Daniel-Wareham/kerbal-controller/README.md

# kerbal-controller
An Arduino custom controller for Kerbal Space Program

Read the project log for my process in building the controller
Read the technical explanation for explanations on both the software and hardware
