Daniel-Wareham/kerbal-controller/Kerbal Body v3.7.stl

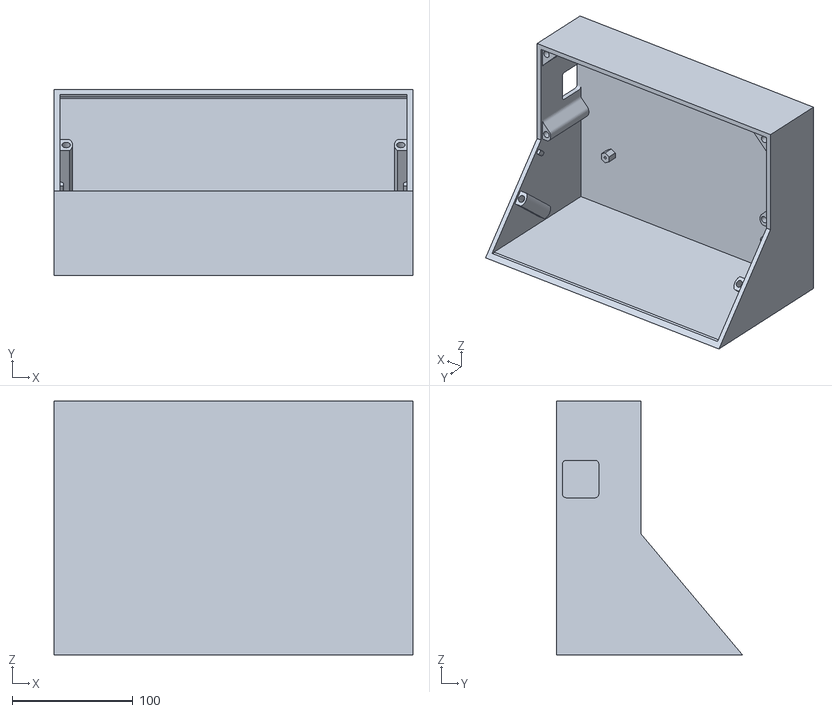
[picture p1: CAD file, 2020-08-31]
Kerbal Body v3.7.stl
297.0 x 153.9 x 210.0
