Daniel-Wareham/kerbal-controller/Kerbal Controller PCB/Kerbal Controller PCB.kicad_pcb

## KiCad design Kerbal Controller PCB/Kerbal Controller PCB.kicad_pcb (2020-08-27)

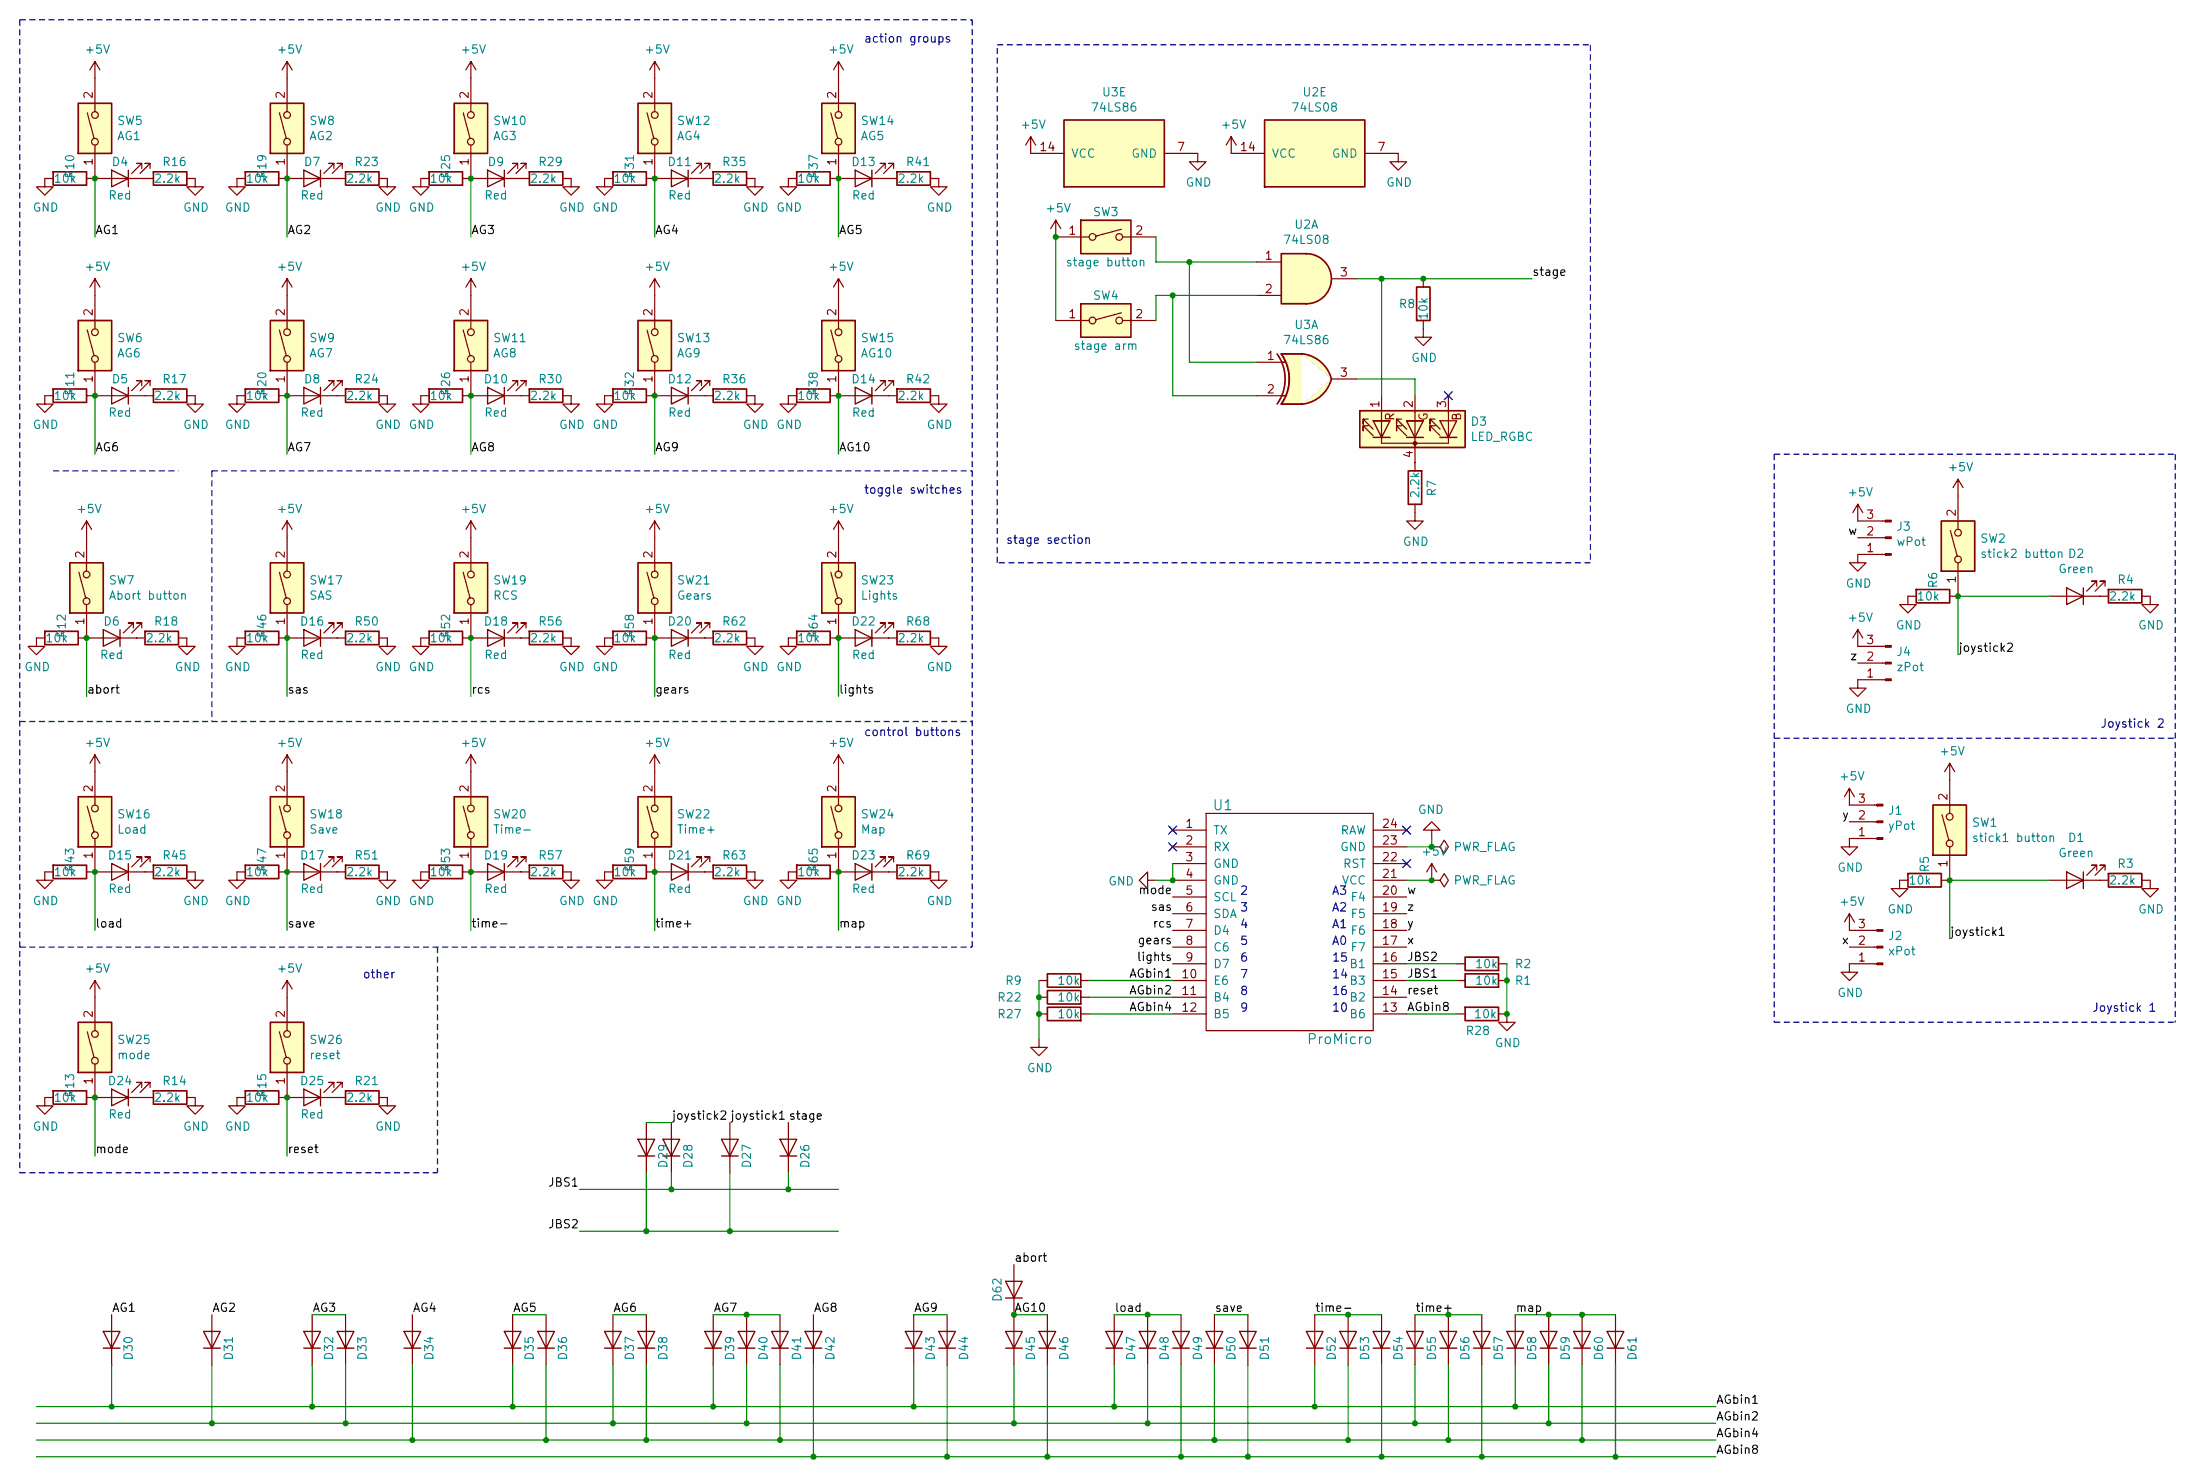
[picture p15: schematic Kerbal Controller PCB.sch]

Parts:
D1, D2: Green; LED_D5.0mm
D3: LED_RGBC; PinSocket_1x04_P2.54mm_Vertical
D4, D5, D6, D7, D8, D9, D10, D11, D12, D13, D14, D15, D16, D17, D18, D19, D20, D21, D22, D23, D24, D25: Red; LED_D5.0mm
D26, D27, D28, D29, D30, D31, D32, D33, D34, D35, D36, D37, D38, D39, D40, D41, D42, D43, D44, D45, D46, D47, D48, D49, D50, D51, D52, D53, D54, D55, D56, D57, D58, D59, D60, D61, D62: D; D_A-405_P7.62mm_Horizontal
J1: yPot; PinHeader_1x03_P2.54mm_Vertical
J2: xPot; PinHeader_1x03_P2.54mm_Vertical
J3: wPot; PinHeader_1x03_P2.54mm_Vertical
J4: zPot; PinHeader_1x03_P2.54mm_Vertical
R1, R2, R5, R6, R8, R9, R10, R11, R12, R13, R15, R19, R20, R22, R25, R26, R27, R28, R31, R32, R37, R38, R43, R46, R47, R52, R53, R58, R59, R64, R65: 10k; R_Axial_DIN0207_L6.3mm_D2.5mm_P7.62mm_Horizontal
R3, R4, R7, R14, R16, R17, R18, R21, R23, R24, R29, R30, R35, R36, R41, R42, R45, R50, R51, R56, R57, R62, R63, R68, R69: 2.2k; R_Axial_DIN0207_L6.3mm_D2.5mm_P7.62mm_Horizontal
SW1: stick1 button; PinHeader_1x02_P2.54mm_Vertical
SW2: stick2 button; PinHeader_1x02_P2.54mm_Vertical
SW3: stage button; PinHeader_1x02_P2.54mm_Vertical
SW4: stage arm; PinHeader_1x02_P2.54mm_Vertical
SW5: AG1; PinHeader_1x02_P2.54mm_Vertical
SW6: AG6; PinHeader_1x02_P2.54mm_Vertical
SW7: Abort button; PinHeader_1x02_P2.54mm_Vertical
SW8: AG2; PinHeader_1x02_P2.54mm_Vertical
SW9: AG7; PinHeader_1x02_P2.54mm_Vertical
SW10: AG3; PinHeader_1x02_P2.54mm_Vertical
SW11: AG8; PinHeader_1x02_P2.54mm_Vertical
SW12: AG4; PinHeader_1x02_P2.54mm_Vertical
SW13: AG9; PinHeader_1x02_P2.54mm_Vertical
SW14: AG5; PinHeader_1x02_P2.54mm_Vertical
SW15: AG10; PinHeader_1x02_P2.54mm_Vertical
SW16: Load; PinHeader_1x02_P2.54mm_Vertical
SW17: SAS; PinHeader_1x02_P2.54mm_Vertical
SW18: Save; PinHeader_1x02_P2.54mm_Vertical
SW19: RCS; PinHeader_1x02_P2.54mm_Vertical
SW20: Time-; PinHeader_1x02_P2.54mm_Vertical
SW21: Gears; PinHeader_1x02_P2.54mm_Vertical
SW22: Time+; PinHeader_1x02_P2.54mm_Vertical
SW23: Lights; PinHeader_1x02_P2.54mm_Vertical
SW24: Map; PinHeader_1x02_P2.54mm_Vertical
SW25: mode; PinHeader_1x02_P2.54mm_Vertical
SW26: reset; PinHeader_1x02_P2.54mm_Vertical
U1: ProMicro
U2: 74LS08; DIP-14_W7.62mm_LongPads
U3: 74LS86; DIP-14_W7.62mm_LongPads

Connections:
+5V: J1.3, J2.3, J3.3, J4.3, SW1.2, SW2.2, SW3.1, SW4.1, SW5.2, SW6.2, SW7.2, SW8.2, SW9.2, SW10.2, SW11.2, SW12.2, SW13.2, SW14.2, SW15.2, SW16.2, SW17.2, SW18.2, SW19.2, SW20.2, SW21.2, SW22.2, SW23.2, SW24.2, SW25.2, SW26.2, U1.21 (VCC), U2.14 (VCC), U3.14 (VCC)
/AG1: D4.2 (A), D30.2 (A), R10.1, SW5.1
/AG2: D7.2 (A), D31.2 (A), R19.1, SW8.1
/AG3: D9.2 (A), D32.2 (A), D33.2 (A), R25.1, SW10.1
/AG4: D11.2 (A), D34.2 (A), R31.1, SW12.1
/AG5: D13.2 (A), D35.2 (A), D36.2 (A), R37.1, SW14.1
/AG6: D5.2 (A), D37.2 (A), D38.2 (A), R11.1, SW6.1
/AG7: D8.2 (A), D39.2 (A), D40.2 (A), D41.2 (A), R20.1, SW9.1
/AG8: D10.2 (A), D42.2 (A), R26.1, SW11.1
/AG9: D12.2 (A), D43.2 (A), D44.2 (A), R32.1, SW13.1
/AG10: D14.2 (A), D45.2 (A), D46.2 (A), D62.1 (K), R38.1, SW15.1
/AGbin1: D30.1 (K), D32.1 (K), D35.1 (K), D39.1 (K), D43.1 (K), D47.1 (K), D52.1 (K), D58.1 (K), R9.2, U1.10 (E6)
/AGbin2: D31.1 (K), D33.1 (K), D37.1 (K), D40.1 (K), D45.1 (K), D48.1 (K), D55.1 (K), D59.1 (K), R22.2, U1.11 (B4)
/AGbin4: D34.1 (K), D36.1 (K), D38.1 (K), D41.1 (K), D50.1 (K), D53.1 (K), D56.1 (K), D60.1 (K), R27.2, U1.12 (B5)
/AGbin8: D42.1 (K), D44.1 (K), D46.1 (K), D49.1 (K), D51.1 (K), D54.1 (K), D57.1 (K), D61.1 (K), R28.2, U1.13 (B6)
/JBS1: D26.1 (K), D28.1 (K), R1.1, U1.15 (B3)
/JBS2: D27.1 (K), D29.1 (K), R2.1, U1.16 (B1)
/abort: D6.2 (A), D62.2 (A), R12.1, SW7.1
/gears: D20.2 (A), R58.1, SW21.1, U1.8 (C6)
/joystick1: D1.2 (A), D27.2 (A), R5.1, SW1.1
/joystick2: D2.2 (A), D28.2 (A), D29.2 (A), R6.1, SW2.1
/lights: D22.2 (A), R64.1, SW23.1, U1.9 (D7)
/load: D15.2 (A), D47.2 (A), D48.2 (A), D49.2 (A), R43.1, SW16.1
/map: D23.2 (A), D58.2 (A), D59.2 (A), D60.2 (A), D61.2 (A), R65.1, SW24.1
/mode: D24.2 (A), R13.1, SW25.1, U1.5 (SCL)
/rcs: D18.2 (A), R52.1, SW19.1, U1.7 (D4)
/reset: D25.2 (A), R15.1, SW26.1, U1.14 (B2)
/sas: D16.2 (A), R46.1, SW17.1, U1.6 (SDA)
/save: D17.2 (A), D50.2 (A), D51.2 (A), R47.1, SW18.1
/stage: D3.1 (RA), D26.2 (A), R8.1, U2.3
/time+: D21.2 (A), D55.2 (A), D56.2 (A), D57.2 (A), R59.1, SW22.1
/time-: D19.2 (A), D52.2 (A), D53.2 (A), D54.2 (A), R53.1, SW20.1
/w: J3.2, U1.20 (F4)
/x: J2.2, U1.17 (F7)
/y: J1.2, U1.18 (F6)
/z: J4.2, U1.19 (F5)
GND: J1.1, J2.1, J3.1, J4.1, R1.2, R2.2, R3.1, R4.1, R5.2, R6.2, R7.1, R8.2, R9.1, R10.2, R11.2, R12.2, R13.2, R14.1, R15.2, R16.1, R17.1, R18.1, R19.2, R20.2, R21.1, R22.1, R23.1, R24.1, R25.2, R26.2, R27.1, R28.1, R29.1, R30.1, R31.2, R32.2, R35.1, R36.1, R37.2, R38.2, R41.1, R42.1, R43.2, R45.1, R46.2, R47.2, R50.1, R51.1, R52.2, R53.2, R56.1, R57.1, R58.2, R59.2, R62.1, R63.1, R64.2, R65.2, R68.1, R69.1, U1.3 (GND), U1.4 (GND), U1.23 (GND), U2.7 (GND), U3.7 (GND)
unnamed: D1.1 (K), R3.2
unnamed: D2.1 (K), R4.2
unnamed: D3.2 (GA), U3.3
unnamed: D3.4 (K), R7.2
unnamed: D4.1 (K), R16.2
unnamed: D5.1 (K), R17.2
unnamed: D6.1 (K), R18.2
unnamed: D7.1 (K), R23.2
unnamed: D8.1 (K), R24.2
unnamed: D9.1 (K), R29.2
unnamed: D10.1 (K), R30.2
unnamed: D11.1 (K), R35.2
unnamed: D12.1 (K), R36.2
unnamed: D13.1 (K), R41.2
unnamed: D14.1 (K), R42.2
unnamed: D15.1 (K), R45.2
unnamed: D16.1 (K), R50.2
unnamed: D17.1 (K), R51.2
unnamed: D18.1 (K), R56.2
unnamed: D19.1 (K), R57.2
unnamed: D20.1 (K), R62.2
unnamed: D21.1 (K), R63.2
unnamed: D22.1 (K), R68.2
unnamed: D23.1 (K), R69.2
unnamed: D24.1 (K), R14.2
unnamed: D25.1 (K), R21.2
unnamed: SW3.2, U2.1, U3.1
unnamed: SW4.2, U2.2, U3.2

Notes on the sheet:
Joystick 2
Joystick 1
stage section
action groups
toggle switches
control buttons
other

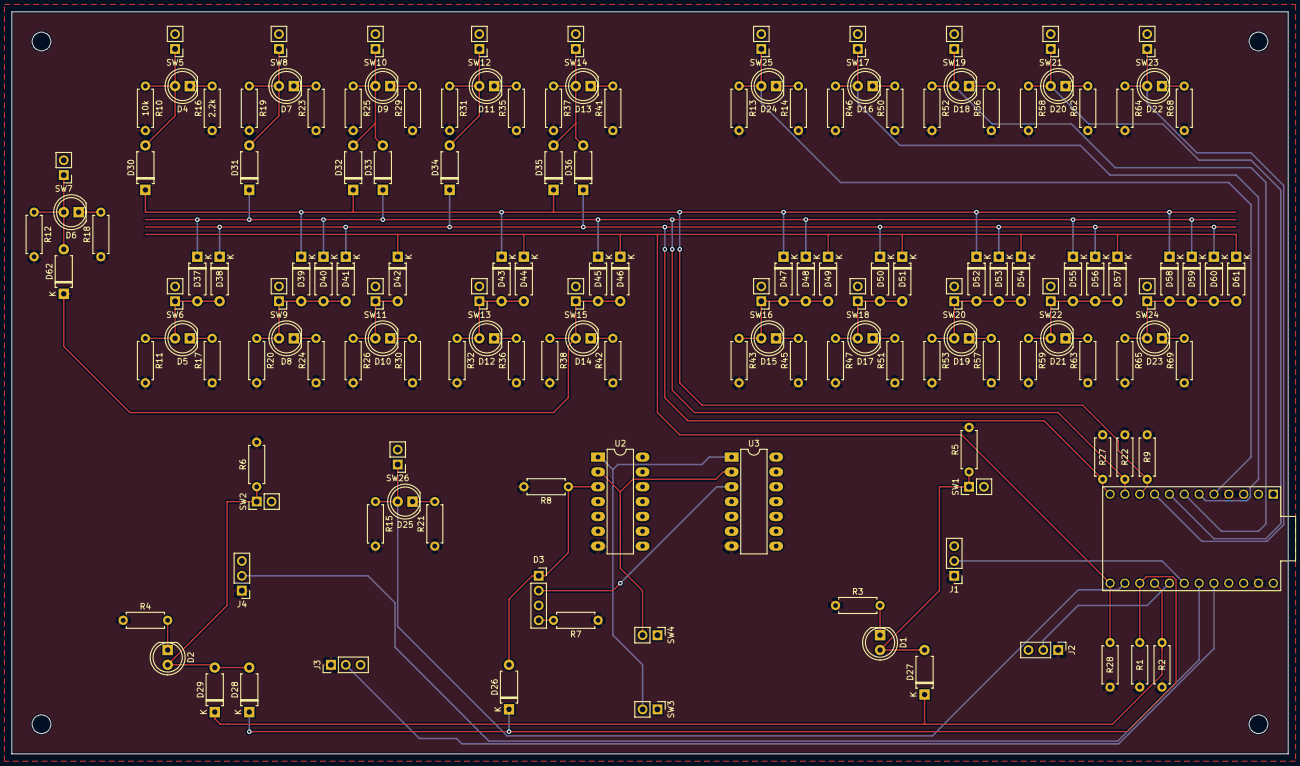
[picture p16: board Kerbal Controller PCB.kicad_pcb from above]

Board: 2 copper layers, 218.4 x 127.0 mm, 151 parts (0 on the bottom side), 65 nets.
